mitjakarki/Blimb/images/blimb_v10_3d_printed_case.jpg

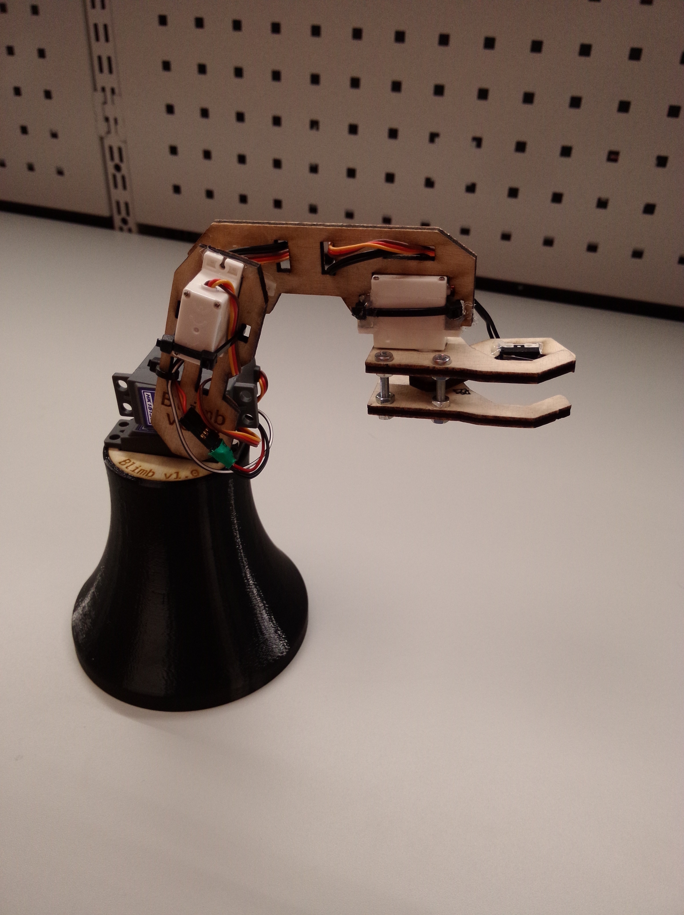
images/blimb_v10_3d_printed_case.jpg
