mitjakarki/Blimb/images/pcb-ala.jpg

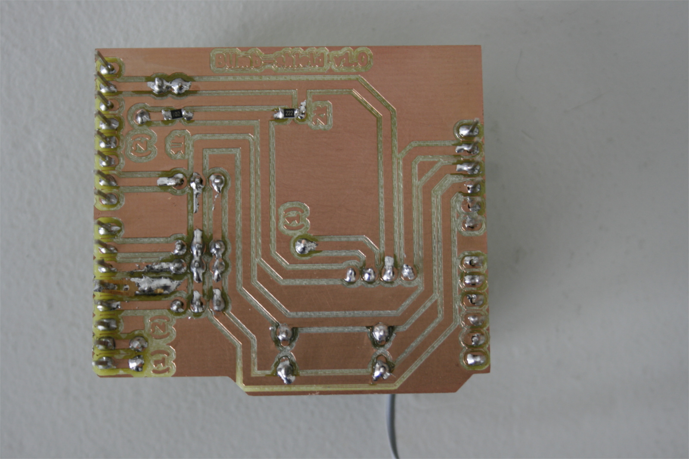
images/pcb-ala.jpg
