mitjakarki/Blimb/README.md

# Blimb
Android app controllable robot arm, Bluetooth Limb.

A Fab Lab project made in Oulu.
Open source excluding the app, so feel free to customize the files. 

Contributors:
Mitja Kärki,
Janne Mustaniemi
