mitjakarki/Blimb/mechanics/blimb-arm&clamp-v10.pdf

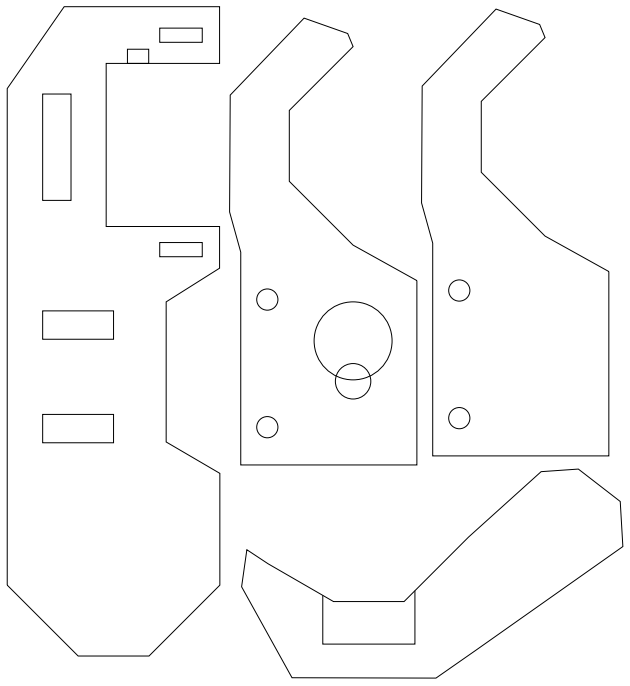
[picture p3: figure]

Blimb
v1.0
