mitjakarki/Blimb/mechanics/lids.pdf

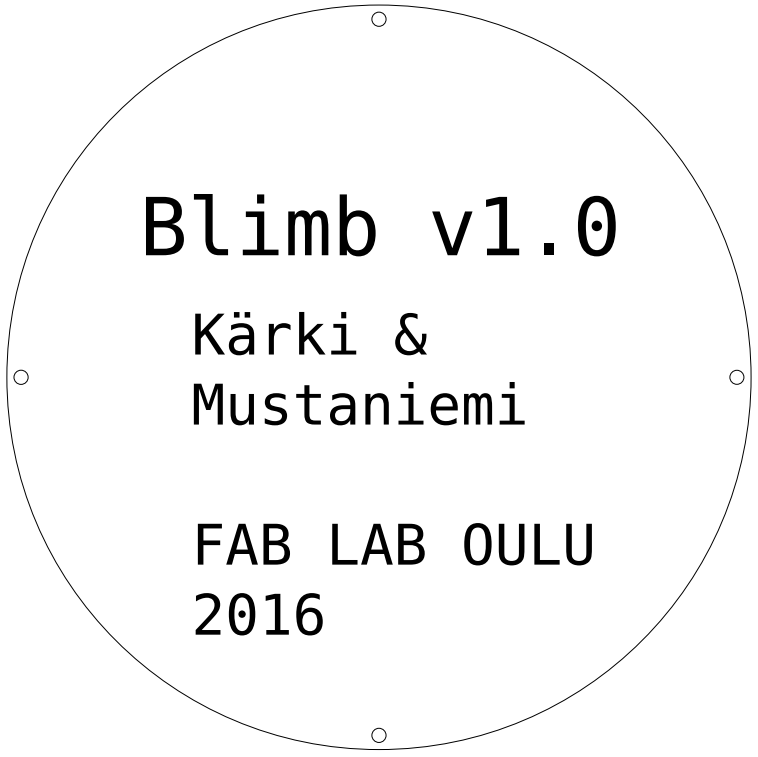
[picture p4: figure]
Kärki & Mustaniemi; FAB LAB OULU 2016; Blimb v1.0

Blimb v1.0
