mitjakarki/Blimb/blimb_shield/v1.0/unscaled_shield_images/Blimb_shield_text.png

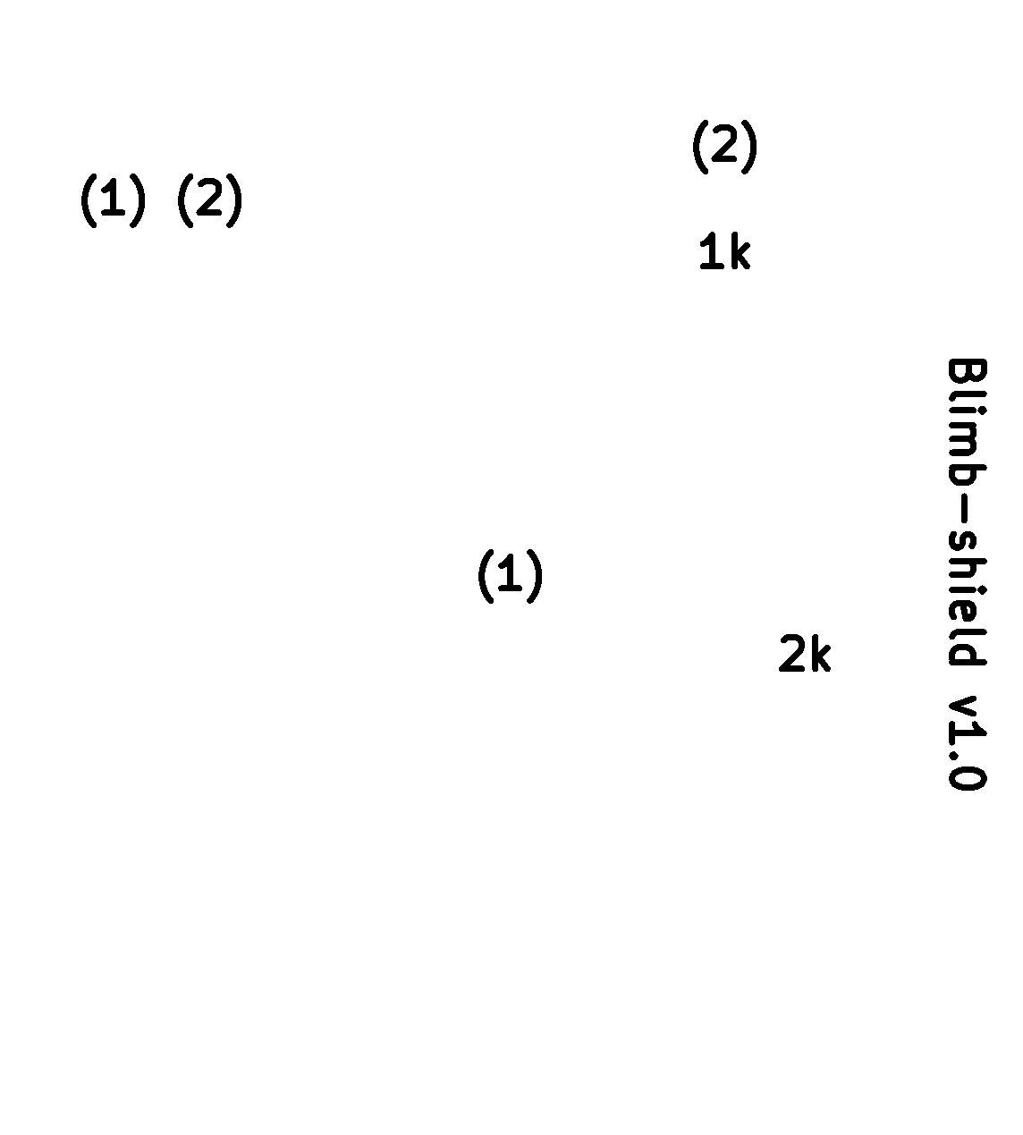
blimb_shield/v1.0/unscaled_shield_images/Blimb_shield_text.png
