mitjakarki/Blimb/blimb_shield/v1.0/unscaled_shield_images/Blimb_shield_traces.png

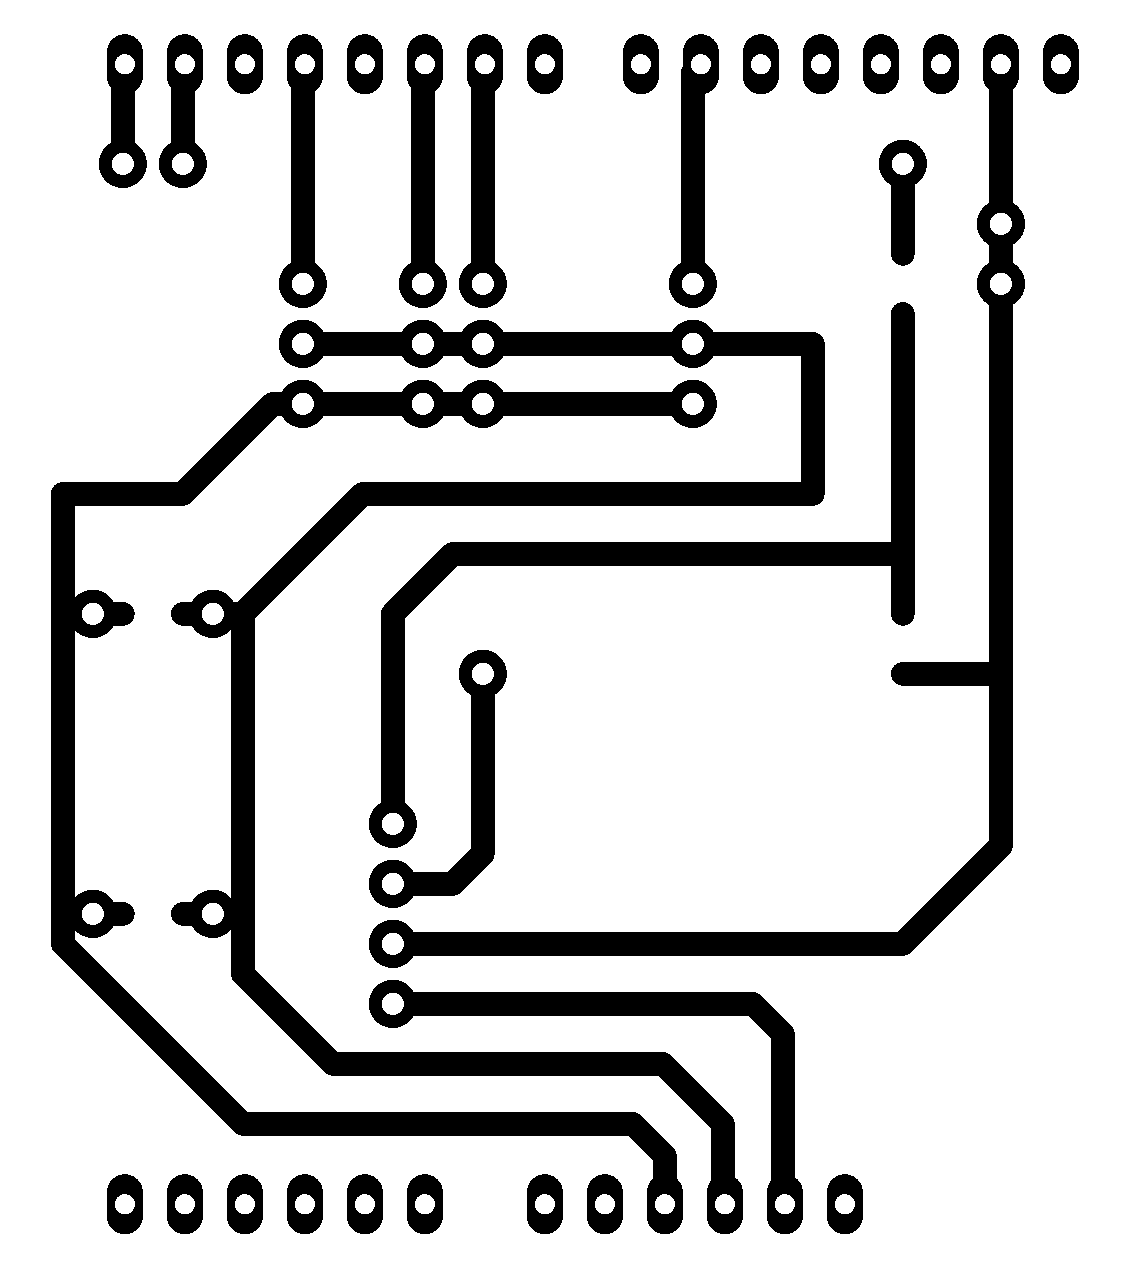
blimb_shield/v1.0/unscaled_shield_images/Blimb_shield_traces.png
