mitjakarki/Blimb/images/blimb_v02_wooden_case.jpg

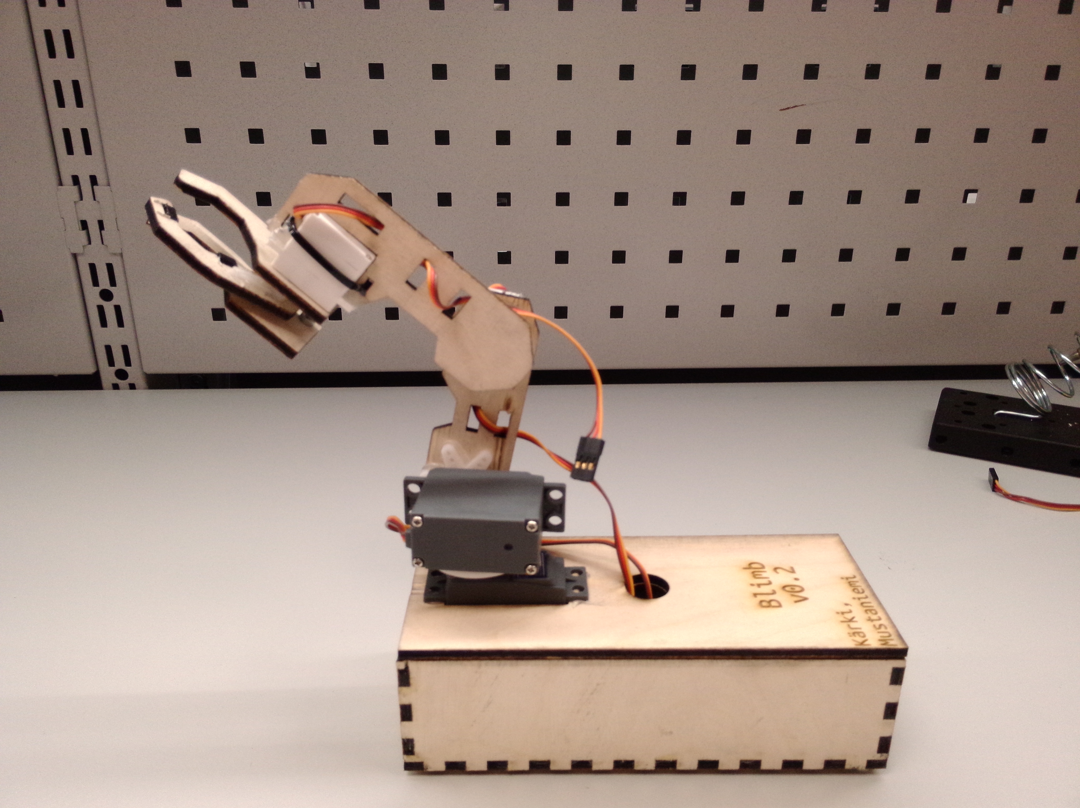
images/blimb_v02_wooden_case.jpg
