mitjakarki/Blimb/images/clamp-sivu.JPG

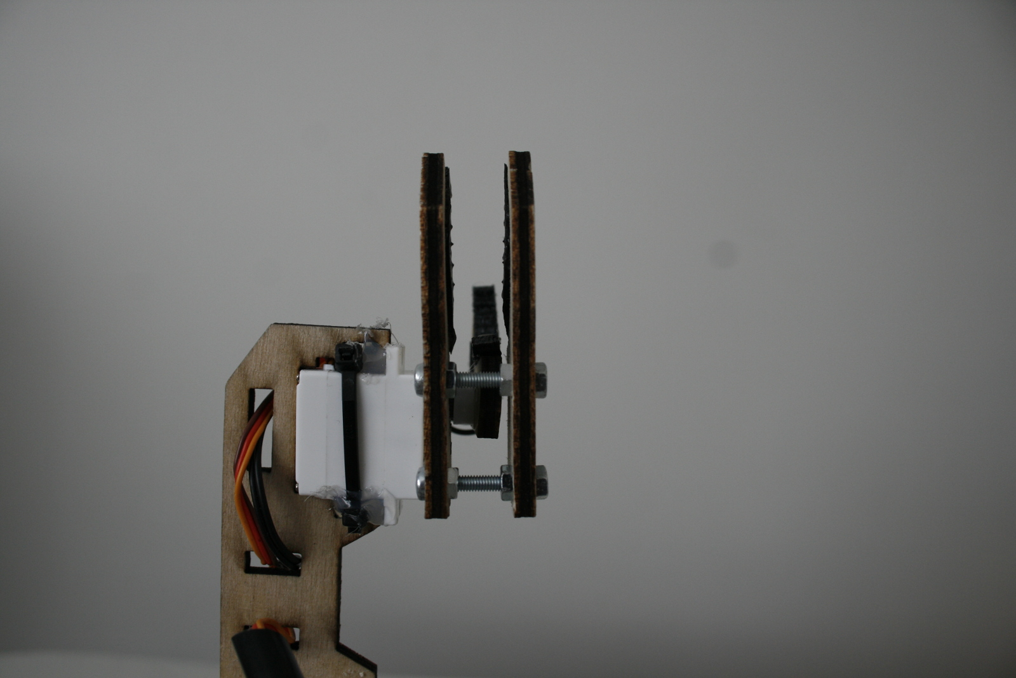
images/clamp-sivu.JPG
