mitjakarki/Blimb/images/clamp-yla.JPG

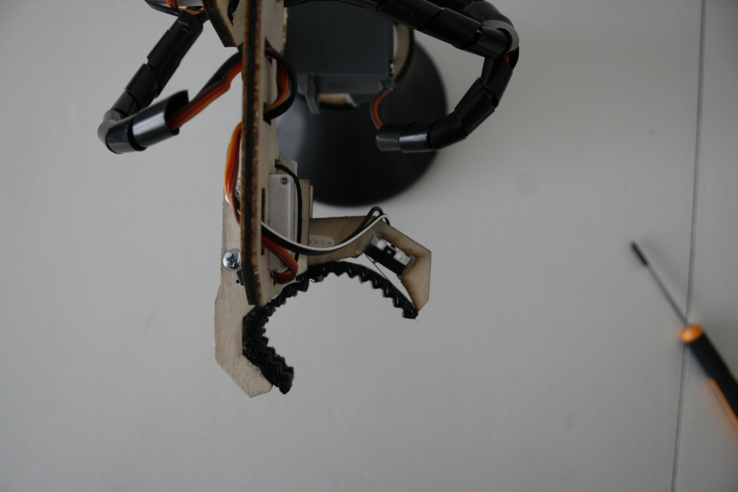
images/clamp-yla.JPG
