mitjakarki/Blimb/images/kasi_ojennettu.JPG

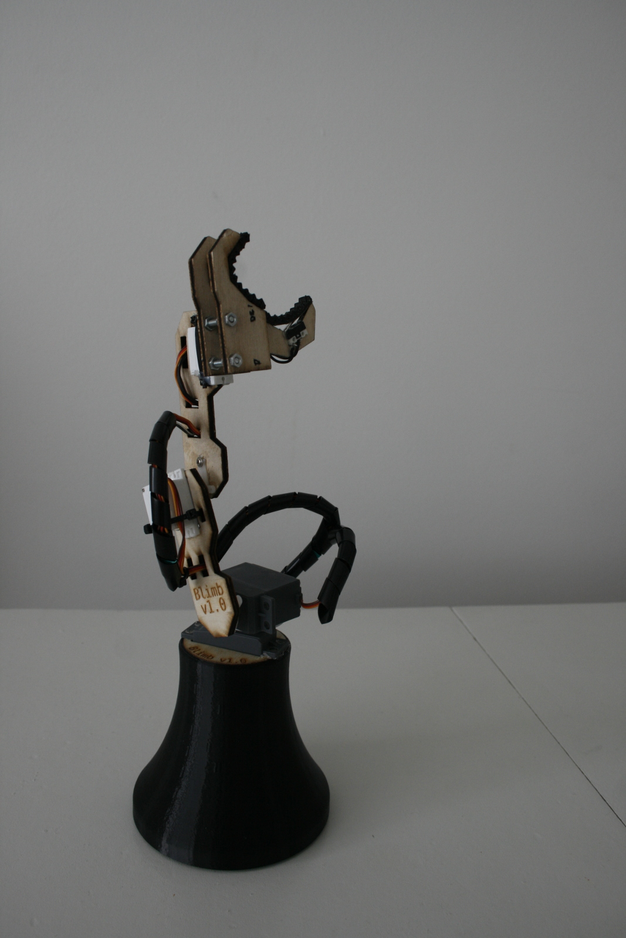
images/kasi_ojennettu.JPG
