mitjakarki/Blimb/images/laturi.JPG

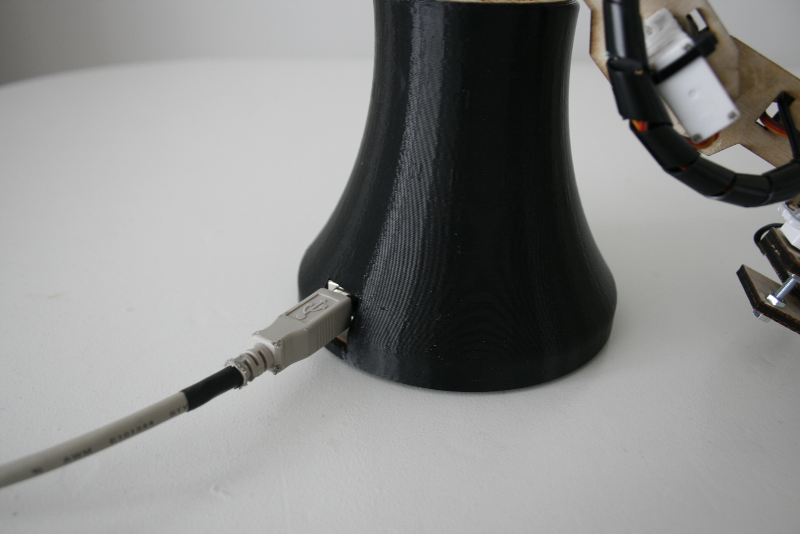
images/laturi.JPG
