mitjakarki/Blimb/images/pcb-yla.jpg

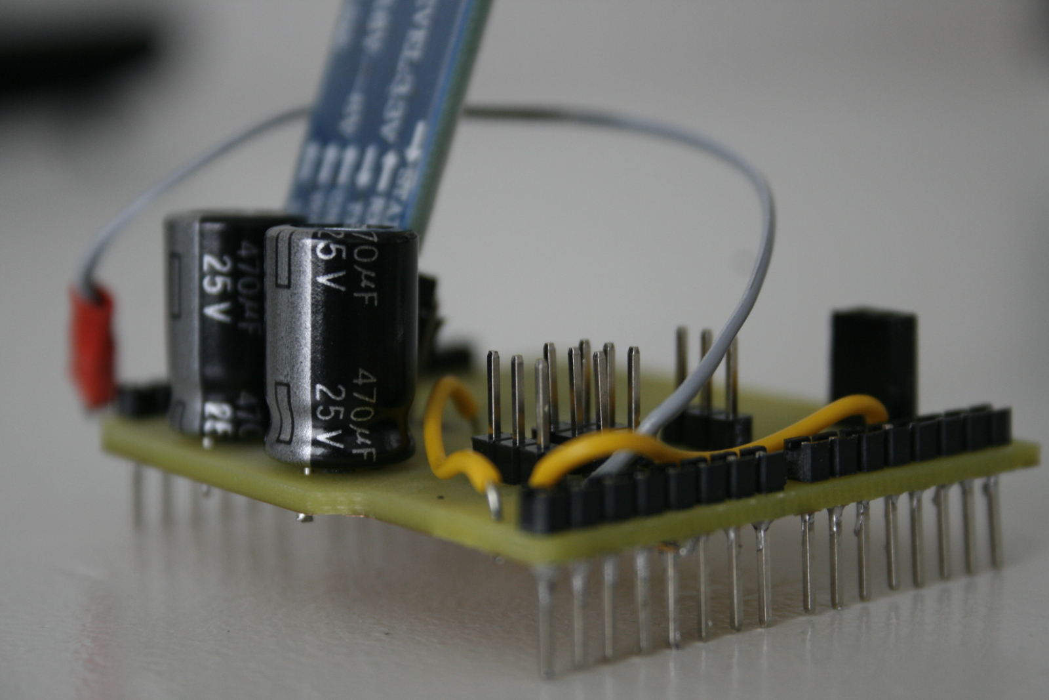
images/pcb-yla.jpg
