mitjakarki/Blimb/images/pohja.JPG

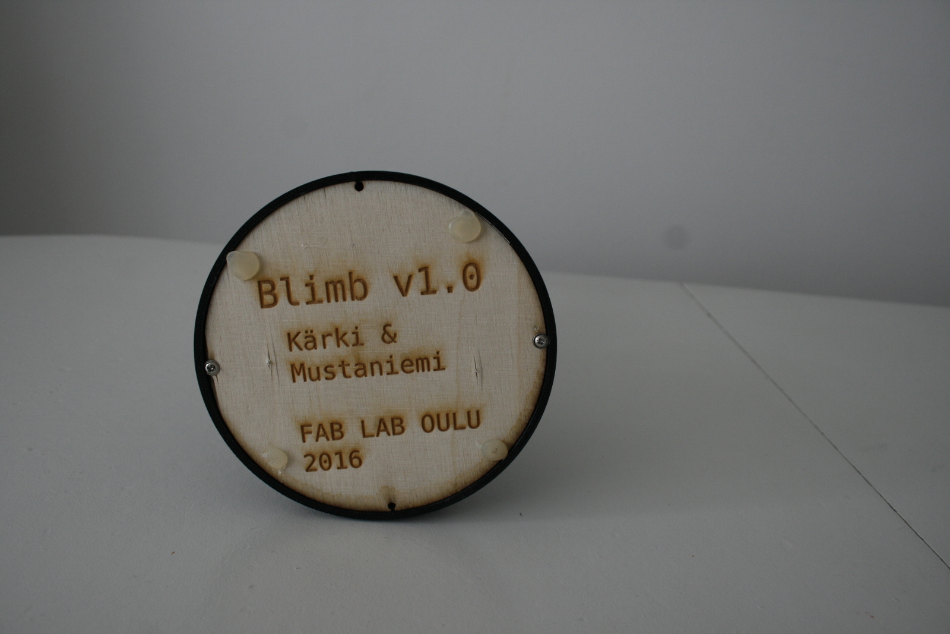
images/pohja.JPG
