mitjakarki/Blimb/images/sisa1.JPG

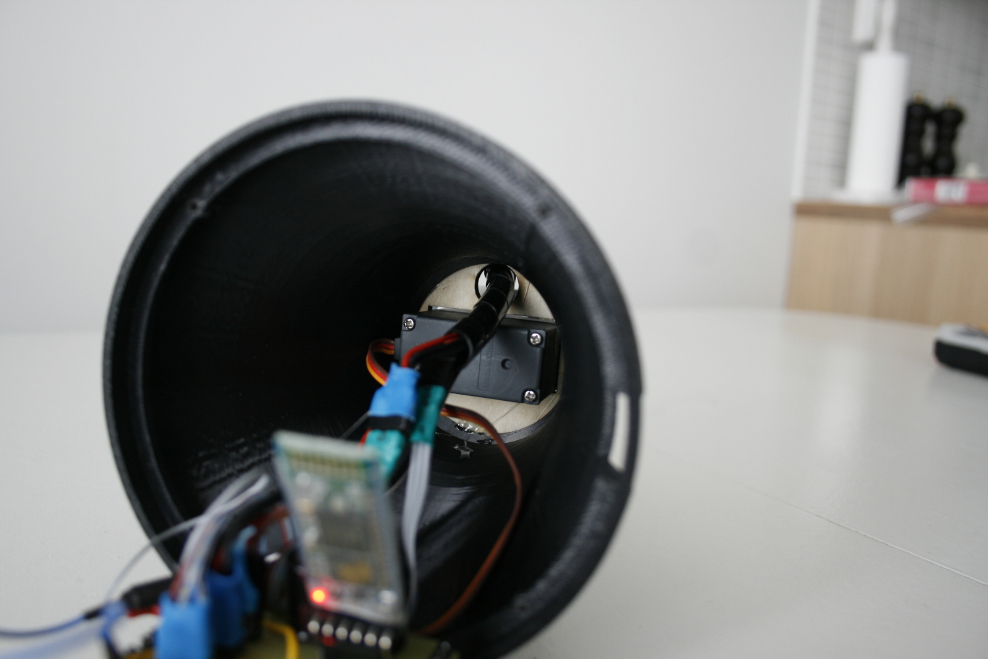
images/sisa1.JPG
