mitjakarki/Blimb/images/sisa2.jpg

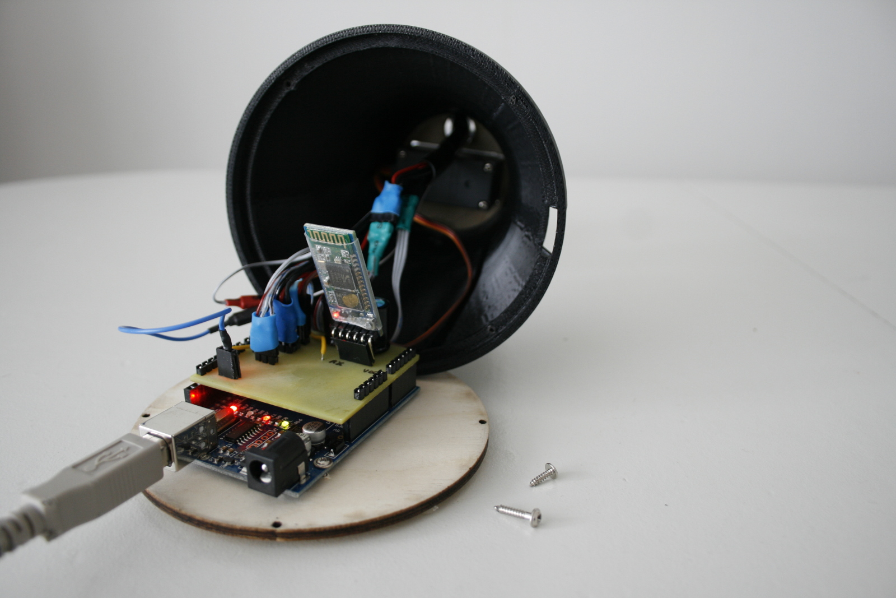
images/sisa2.jpg
