mitjakarki/Blimb/images/sivu-sisa.JPG

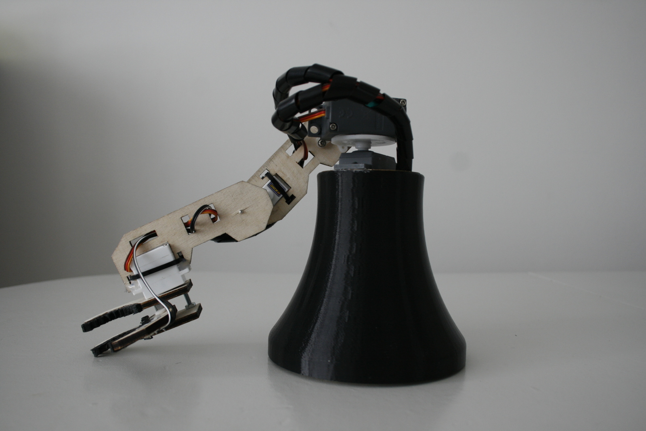
images/sivu-sisa.JPG
