mitjakarki/Blimb/images/sivu-ulko.JPG

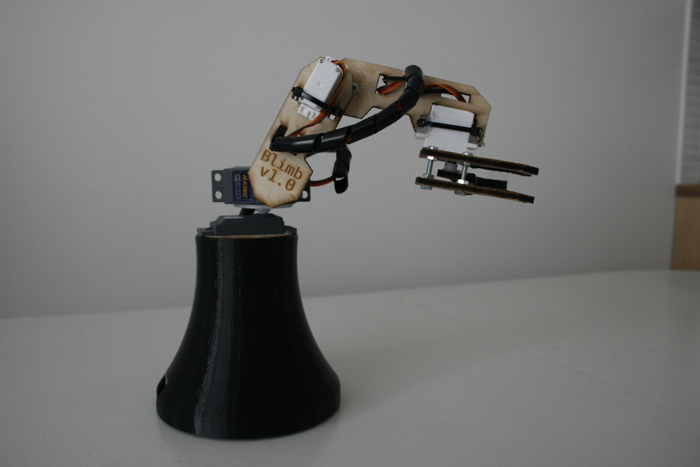
images/sivu-ulko.JPG
