mitjakarki/Blimb/images/tikkuaski.JPG

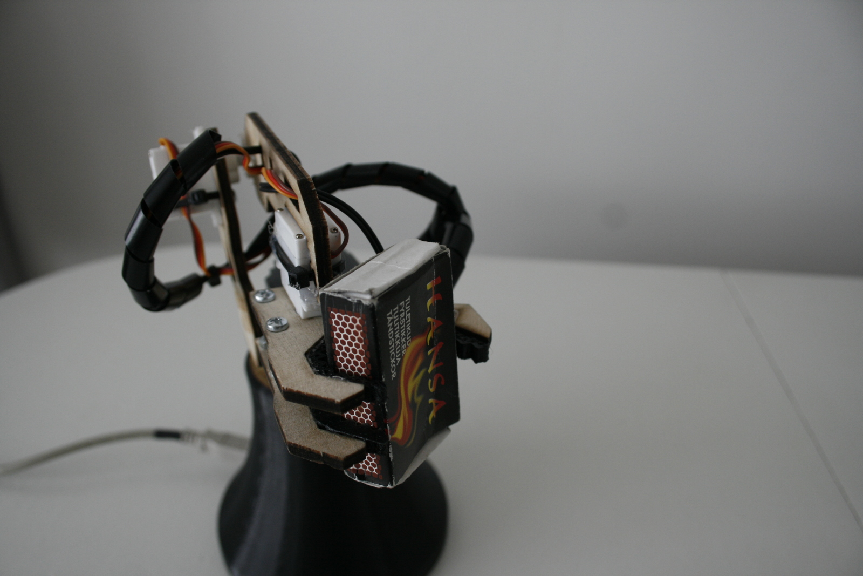
images/tikkuaski.JPG
