mitjakarki/Blimb/images/yleiskuva.jpg

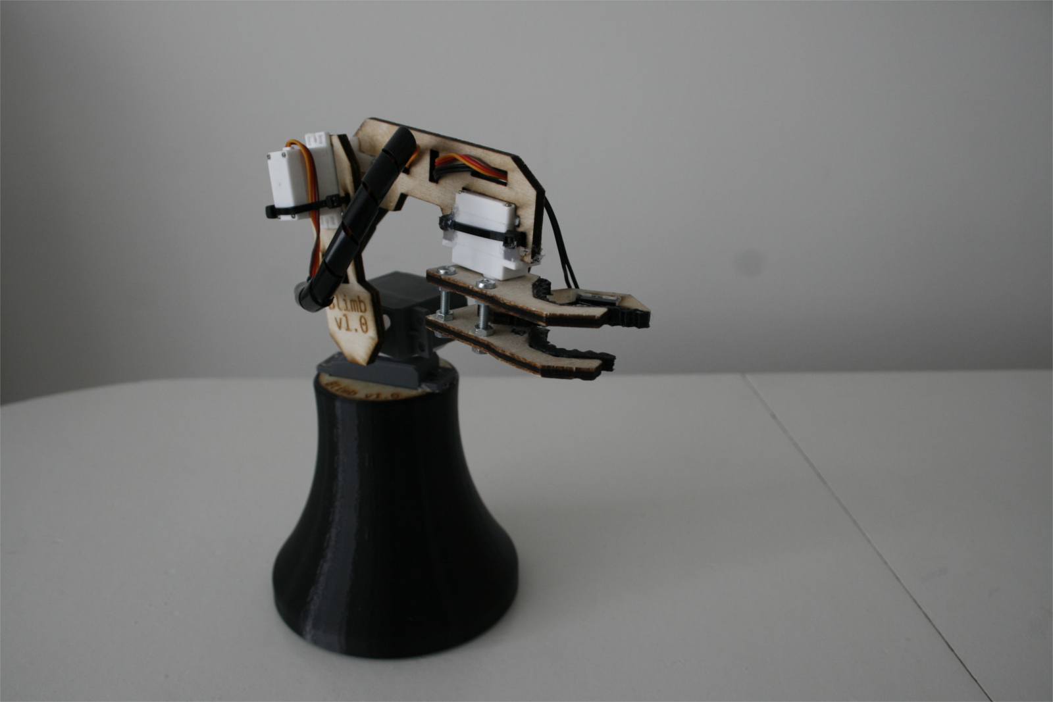
images/yleiskuva.jpg
