mitjakarki/Blimb/images/ylhaalta.JPG

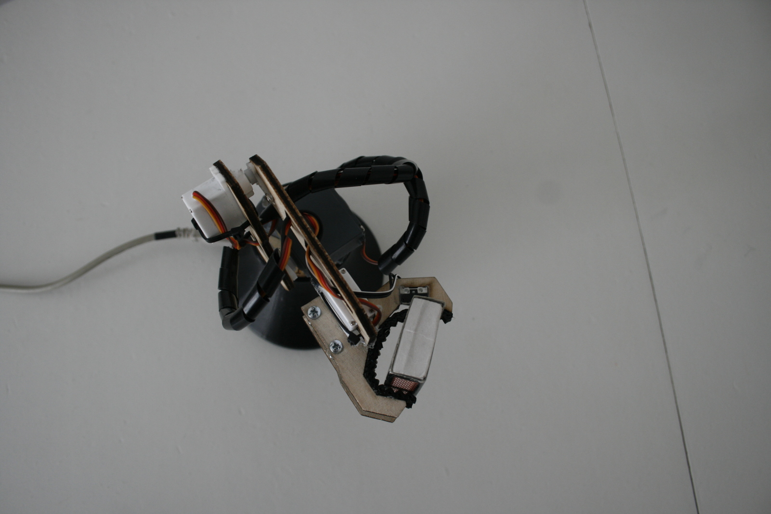
images/ylhaalta.JPG
