mitjakarki/Blimb/mechanics/clamp_rubber2.fcstd

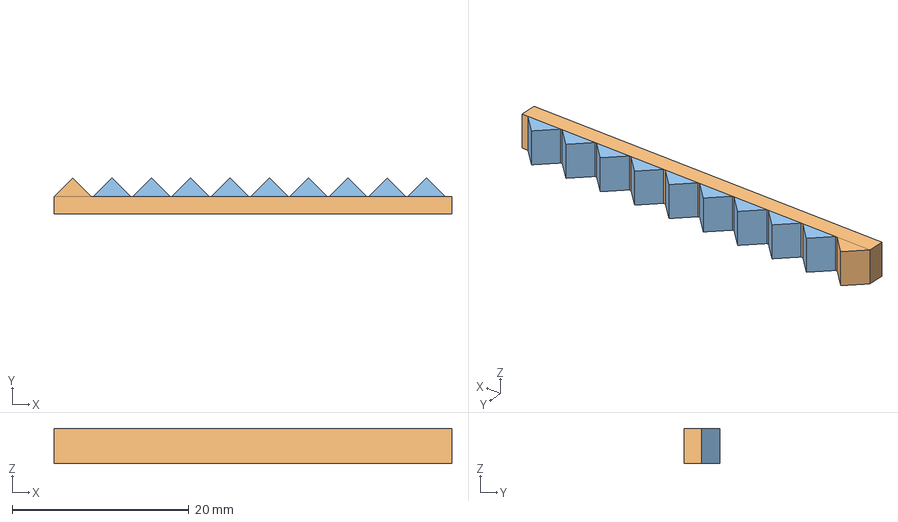
[picture p22: CAD file, 2016-05-16]
mechanics/clamp_rubber2.fcstd
45.0 x 4.12 x 4.00 mm
