mitjakarki/Blimb/mechanics/frame_v10_3dprinted.fcstd

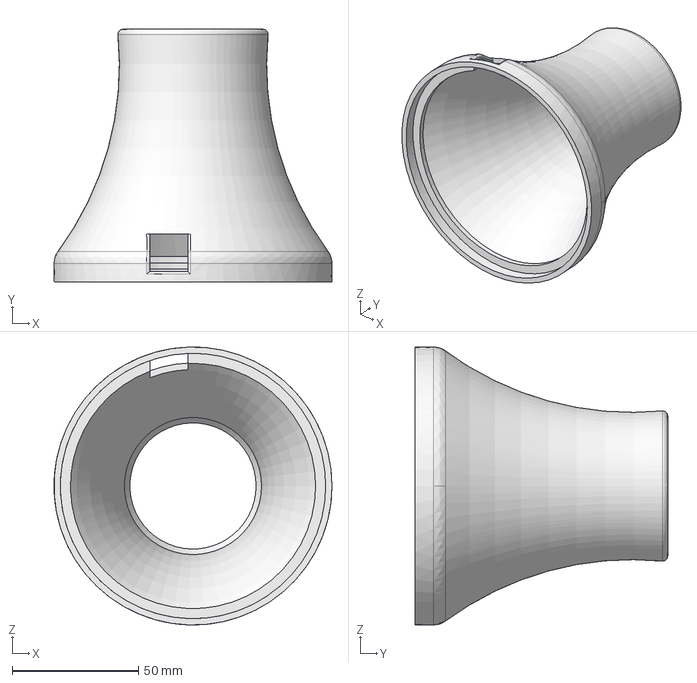
[picture p23: CAD file, 2016-05-16]
mechanics/frame_v10_3dprinted.fcstd
110.1 x 100.0 x 110.0 mm
