mitjakarki/Blimb/(list of files, cad)

Other CAD files:
mechanics/bottom_lid.fcstd
mechanics/top_lid.fcstd
mechanics/clamp_rubber2.stl
mechanics/frame_v10_3dprinted.stl
