mitjakarki/Blimb/blimb_shield/v1.0/KiCad_exported/blimb-shield-B.Cu.pdf

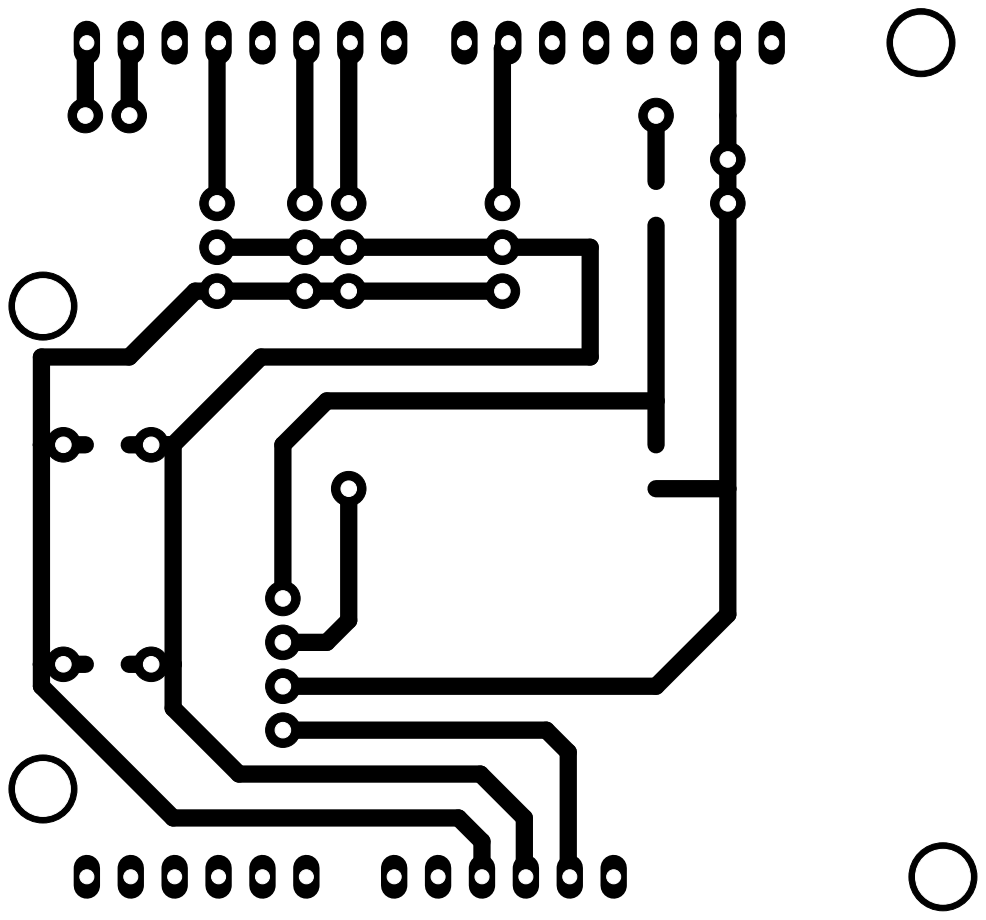
[picture p24: page 1]
