mitjakarki/Blimb/blimb_shield/v1.0/KiCad_exported/blimb-shield-B.SilkS.pdf

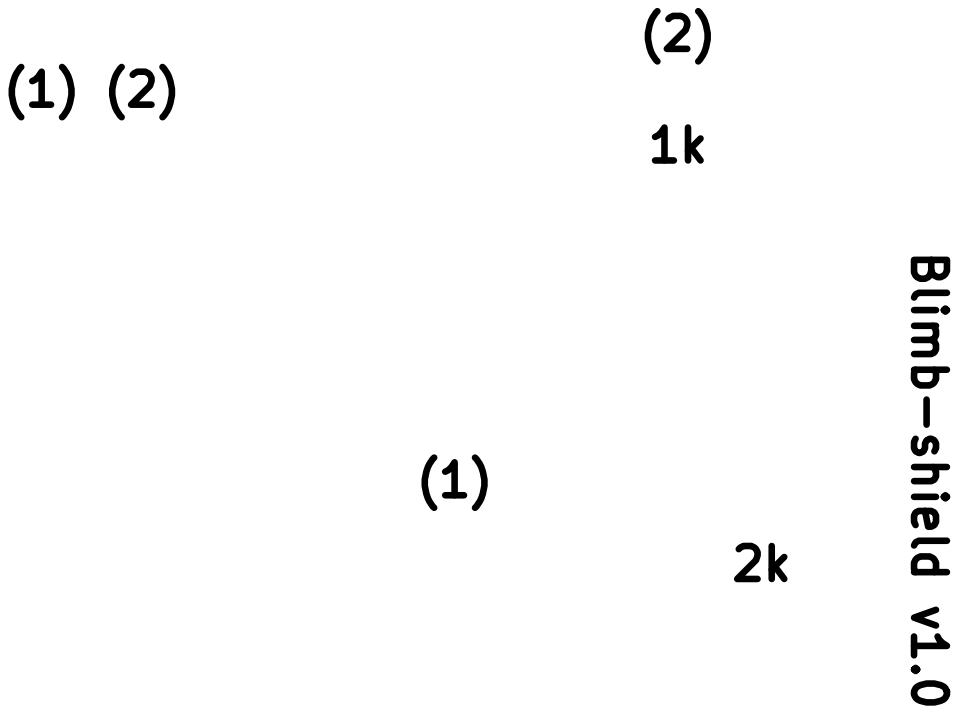
[picture p25: page 1]
