mitjakarki/Blimb/blimb_shield/v1.0/KiCad_exported/blimb-shield-F.SilkS.pdf

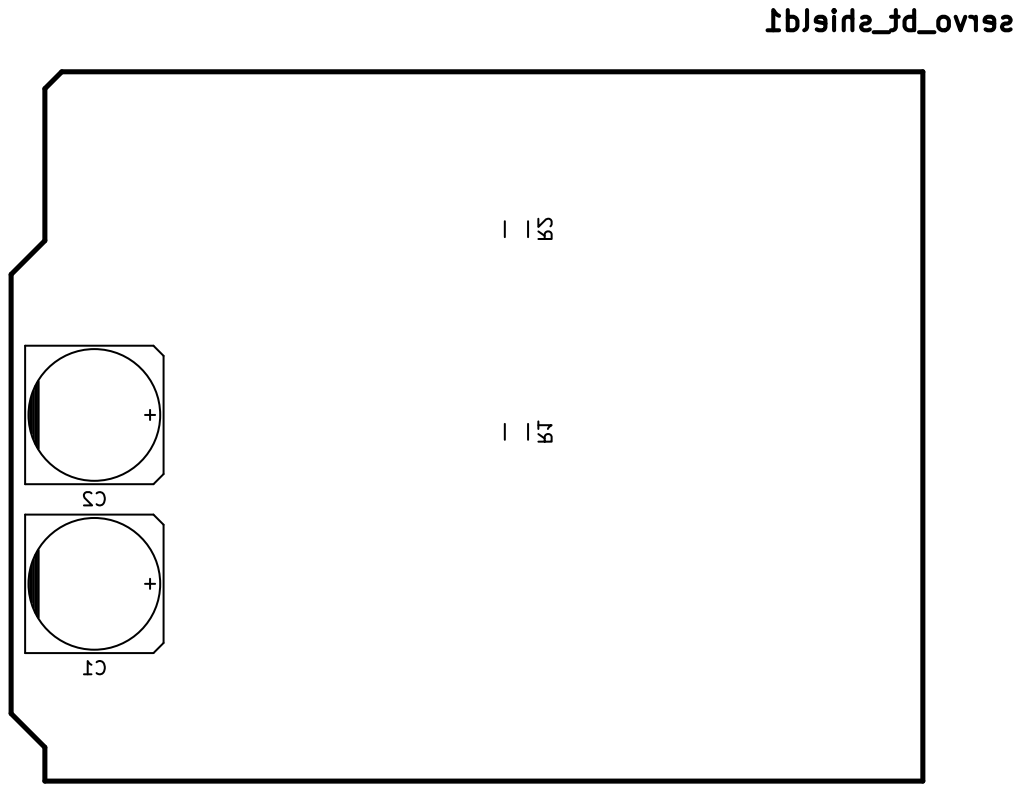
[picture p26: page 1]
