mitjakarki/Blimb/blimb_shield/v0.2/blimb-shield-F.Cu.pdf

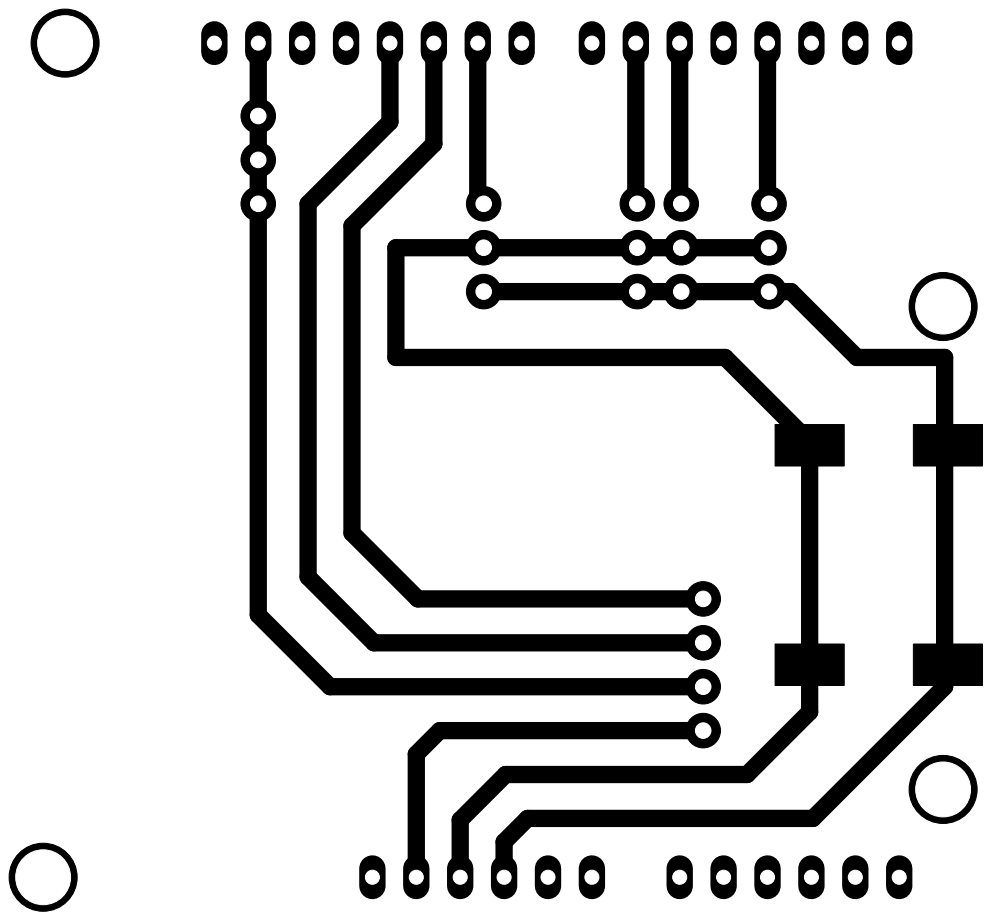
[picture p27: page 1]
