mitjakarki/Blimb/blimb_shield/v0.2/blimb-shield-F.SilkS.pdf

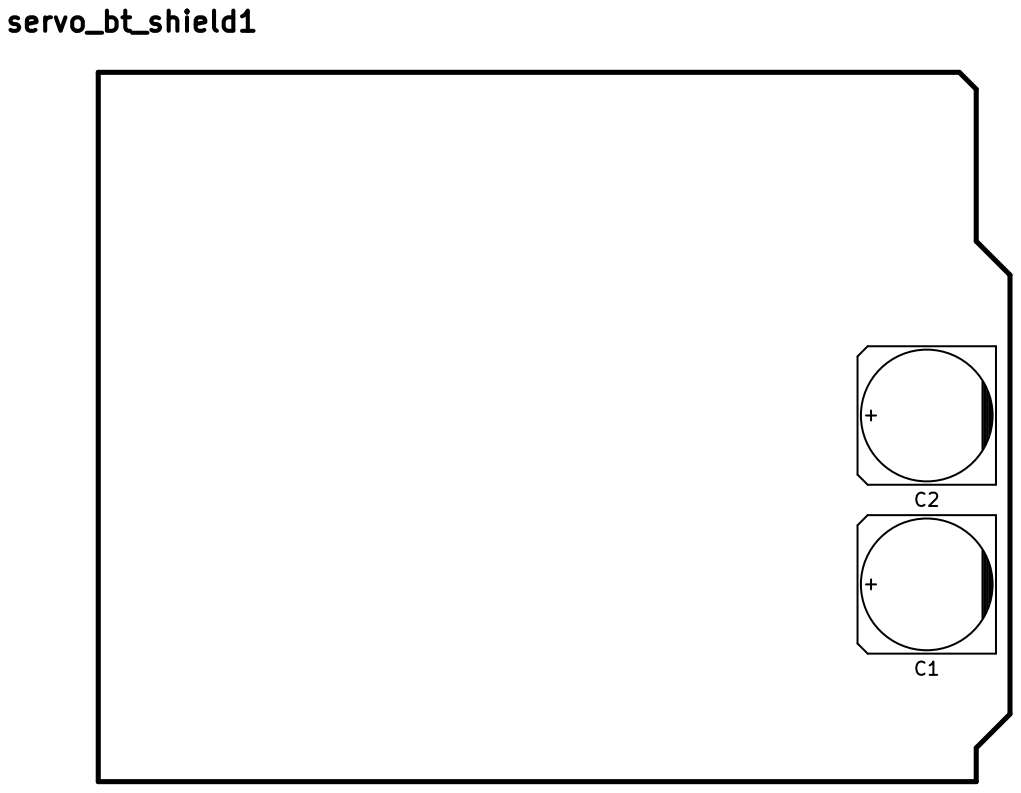
[picture p28: page 1]
