mitjakarki/Blimb/blimb_shield/blimb-shield.kicad_pcb

## KiCad design blimb_shield/blimb-shield.kicad_pcb (2016-05-16)

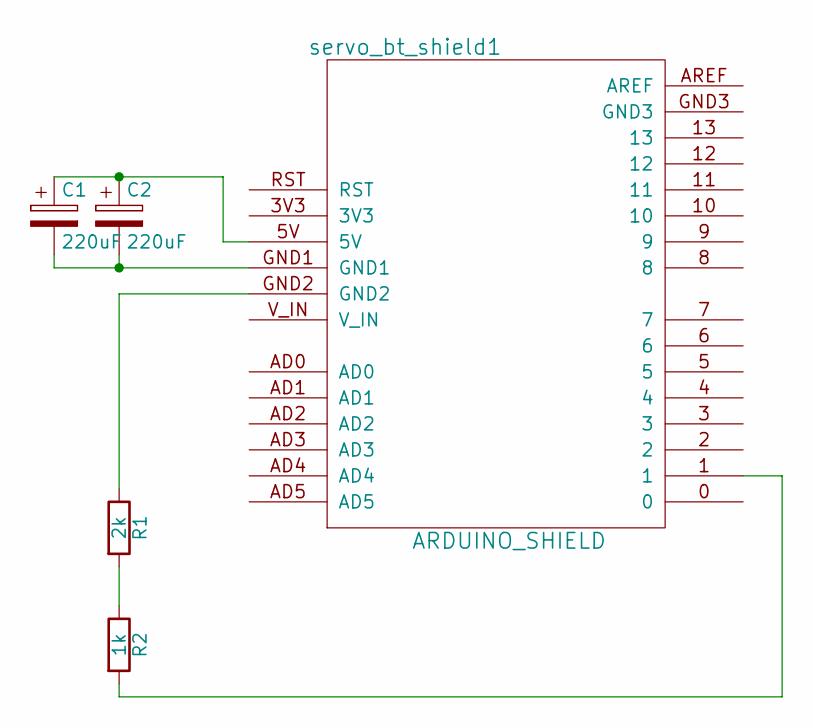
[picture p29: schematic blimb-shield.sch]

Parts:
C1, C2: 220uF; c_elec_10x10.5
R1: 2k; R_0805
R2: 1k; R_0805
servo_bt_shield1: ARDUINO_SHIELD; ARDUINO SHIELD

Connections:
unnamed: C1.1, C2.1, servo_bt_shield1.5V
unnamed: C1.2, C2.2, servo_bt_shield1.GND1
unnamed: R1.1, servo_bt_shield1.GND2
unnamed: R1.2, R2.1
unnamed: R2.2, servo_bt_shield1.1

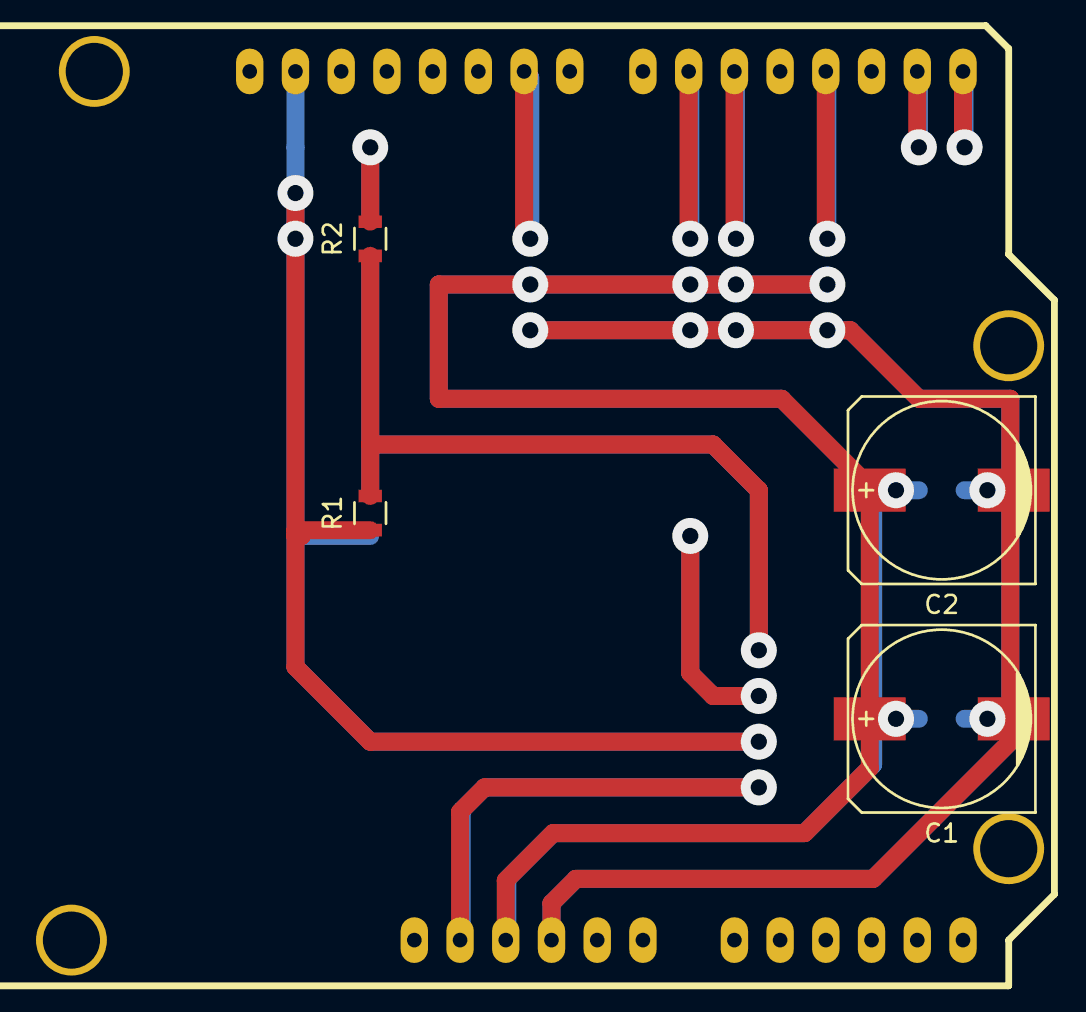
[picture p30: board blimb-shield.kicad_pcb from above]

Board: 2 copper layers, 5 parts (0 on the bottom side), 5 nets.
