mitjakarki/Blimb/(commit log)

2016-05-16 Added files to manufacture the whole robot
    [blimb-shield.kicad_pcb, blimb-shield.sch, bottom_lid.fcstd, clamp_rubber2.fcstd, clamp_rubber2.stl, frame_v10_3dprinted.fcstd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]
2016-05-21 Made a separate version for Arduino code with OLED debugging feature, removing it from the original.
